www666www6661/WEILAI-DAFU-HW/production/dafu/gerbers/drill-report.txt

Drill report for DAFU.kicad_pcb
Created on 2026-10-12T19:56:31

Copper Layer Stackup:
    =============================================================
    L1 :  F.Cu                      front
    L2 :  B.Cu                      back

Drill file 'DAFU.drl' contains
    plated through holes:
    =============================================================
    T1  0.300mm  0.0118"  (74 holes))

    Total plated holes count 74

Not plated through holes are merged with plated holes
    unplated through holes:
    =============================================================

    Total unplated holes count 0
