www666www6661/WEILAI-DAFU-HW/production/dafu/documentation/LAYOUT-NOTES.md

# DAFU-DEMO-V0.2.1 生产文件说明

生成日期：2026-10-12。按用户最新保存的正式工程导出，包含此次 U6、U9 替换及后续手动修改。

PCB SHA-256：`16c16d32f7731cb15bf84564cf54f34b62e3aa2eb81f13218ef568a6f13b8d69`。

## 当前板数据

- 双层板，板厚 1.6 mm，板框 30.0 × 31.6 mm，四角各 1 mm 倒角，面积 946.0 mm²。
- 47 个封装：45 个正面、2 个底面；底面仅 TP5、TP6 裸测试焊盘。实际装配元件 42 个，均在正面。
- 322 段走线、74 个过孔，全部过孔孔径 0.30 mm；GND 过孔 50 个。
- 已保存的底层 GND 为单个实心直连铺铜区和单个填充多边形。
- 已保存的原生泪滴 279 个，正面 253 个、底面 26 个，全部有填充。
- 底层丝印板名 `DAFU-DEMO-V0.2.1`，文字 `CONF_CONC`，日期 `2026-10-12`。

本次直接按已保存的铜区、泪滴导出，未重新填铜、重新生成泪滴或修改正式工程。Gerber、钻孔和铜层预览来自正式 PCB 的精确快照；装配用临时副本仅用于显示标号和正确处理 C11 不装属性。

3D 预览也使用装配副本，以正确显示 C11 不装；正式生产铜层和钻孔使用原 PCB。

## 装配

- U6 为 TI `TLC2274AIDR`，U9 为 UMW `OPA333AIDBVR`。BOM 已带上工程中已有的 Manufacturer、MPN；缺失的采购料号保留空白。
- C11 在原理图标注 DNP，PCB 未同步这个属性。本次 BOM 按原理图明确标为不装，贴装坐标排除 C11，装配图对其打叉。其铜、阻焊和锡膏开窗保持源 PCB 原样。
- 正面贴装 CSV 仅含 42 个实际装配元件，底面贴装 CSV 无元件；TP1、TP2、TP5、TP6 为裸焊盘，不进入贴装文件。
- `DAFU-reference-positions.csv` 含全部 47 个标号的检查坐标，使用 PCB 中原始的正 Y 坐标，不能作为贴装文件。
- 正反面贴装 CSV 使用 KiCad 绝对原点、毫米单位、X 和取负后的 Y；角度沿用 KiCad。背面装配图和预览以从板背面观察的方向镜像，Gerber 不镜像。

## 检查及现有警告

- KiCad 10.0.5 ERC：0 项违规。
- PCB 检查包括全部走线错误、全部严重级别及原理图一致性：活动违规 0 项，未连接 0 项。
- 原有 5 项一致性警告保留：C11 DNP 属性不一致，以及 U2 缺少 10、17、18、19 号焊盘。原理图中这四脚均标注 No Connect。
- 实际 MCU 仍有 48 个引脚；上述四脚在源 PCB 和本生产图层中均没有铜焊盘、阻焊及锡膏开窗。
- 原有 1 项已排除的 U2 封装库不匹配警告保留，本次未新增排除规则。本版不能描述为 DRC 全零。
- 全部贴装坐标与源 PCB 核对，全部 74 个钻孔坐标与过孔核对；预览和装配图完成目视检查。

## 输出

- `gerbers/`：8 个生产图层、Gerber job、Excellon 钻孔及钻孔报告。底层无锡膏，不输出 B.Paste。
- `assembly/`：BOM、正反面贴装坐标、全标号检查坐标、正反面装配 SVG/PDF。
- `previews/`：最新正反面铜层、丝印 SVG/PNG 和 3D PNG。
- `documentation/`：本版 DRC、ERC、板数据、核查及本说明。
- `manifest.json`：源文件及输出文件 SHA-256；`../dafu.zip.sha256` 为完整压缩包校验值。
- `../dafu-gerbers.zip`：单独的打板压缩包，仅含 `gerbers/` 下的文件，便于上传板厂。

2026-10-16 按仓库格式整理至 `production/dafu/`，更新归档名称及校验清单；生产图层、钻孔、BOM、贴装坐标和装配图保持 2026-10-12 导出内容。

本次完成生产输出及文件核对，未实测冲击波形、噪声、量程或采样性能。
