www666www6661/WEILAI-DAFU-HW/production/dafu/previews/back-3d.png

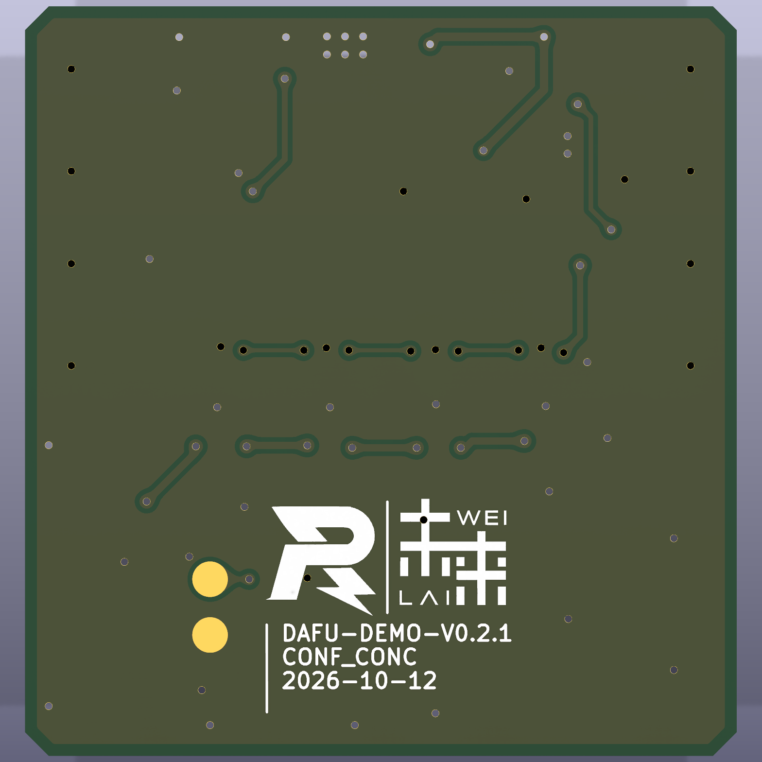
production/dafu/previews/back-3d.png
