www666www6661/WEILAI-DAFU-HW/production/dafu/previews/back-copper.png

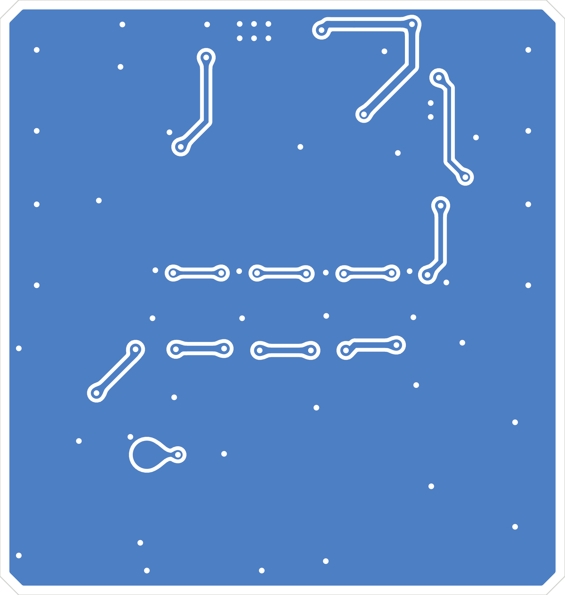
production/dafu/previews/back-copper.png
