www666www6661/WEILAI-DAFU-HW/production/dafu/previews/back-silkscreen.png

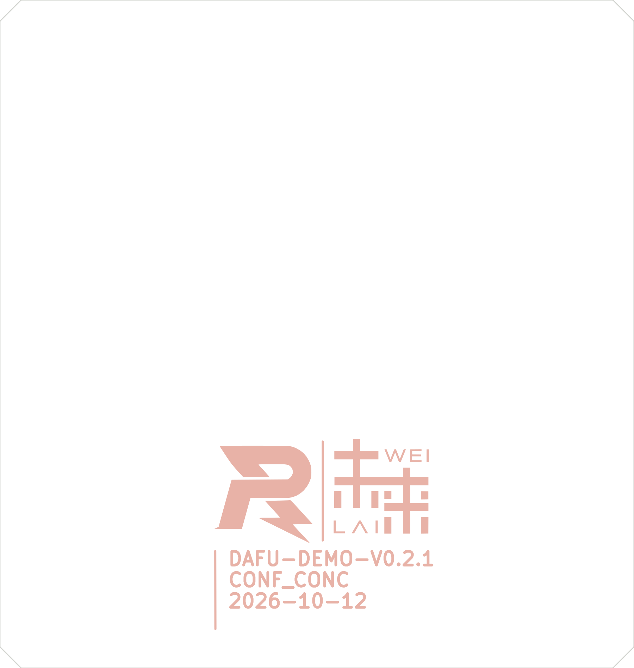
production/dafu/previews/back-silkscreen.png
