www666www6661/WEILAI-DAFU-HW/production/dafu/previews/front-3d.png

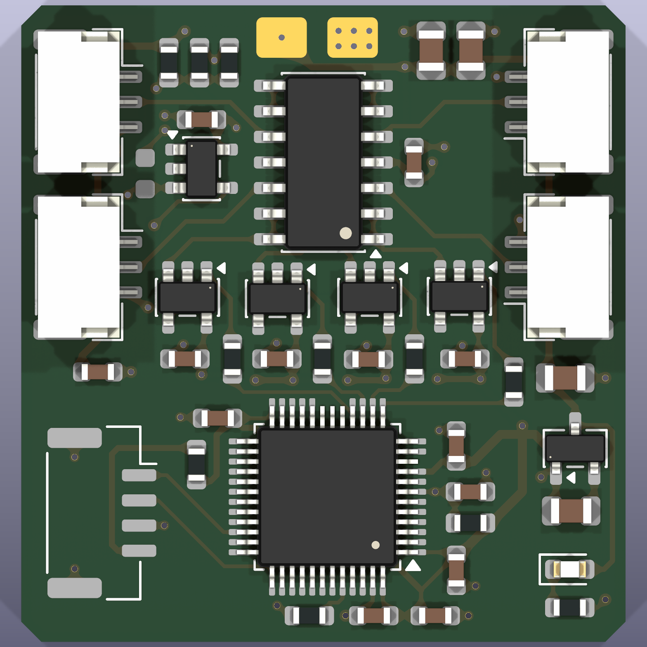
production/dafu/previews/front-3d.png
