www666www6661/WEILAI-DAFU-HW/production/dafu/previews/front-copper.png

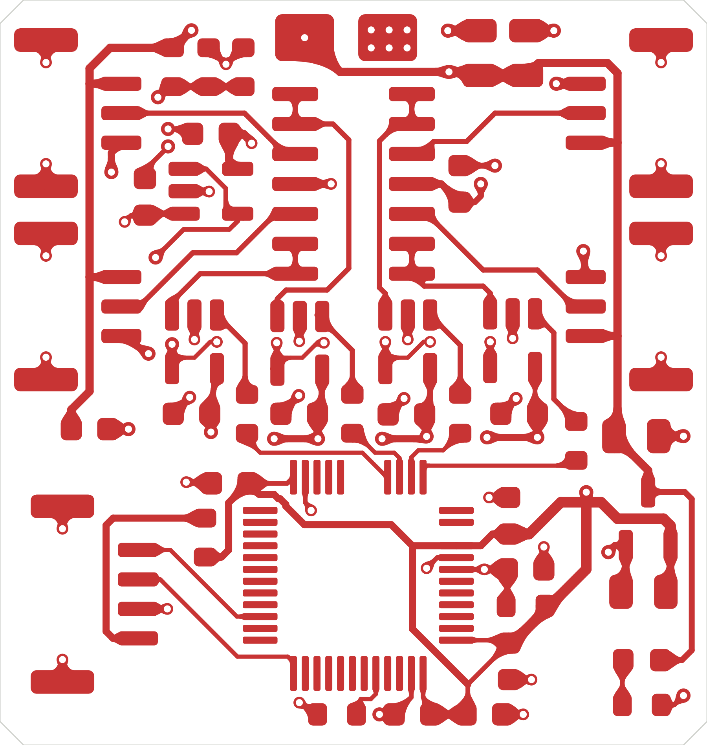
production/dafu/previews/front-copper.png
