www666www6661/WEILAI-DAFU-HW/production/dafu/previews/front-silkscreen.png

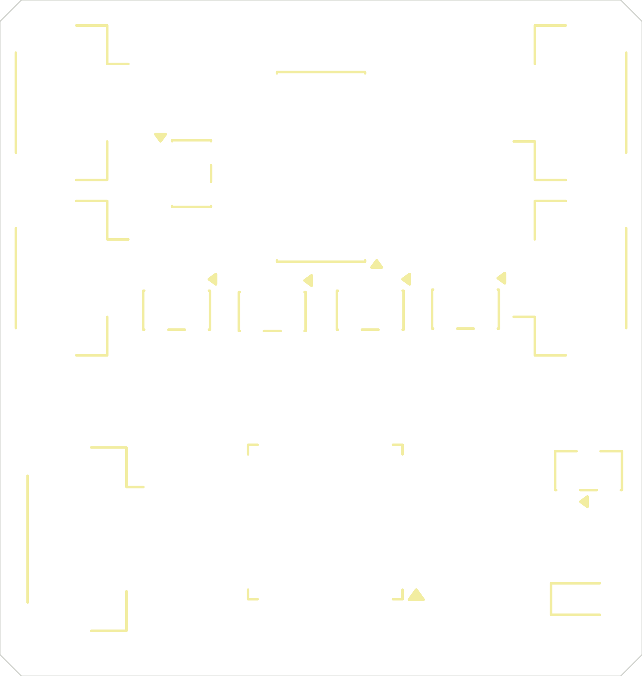
production/dafu/previews/front-silkscreen.png
