www666www6661/WEILAI-DAFU-HW/production/dafu/assembly/DAFU-back-assembly.pdf

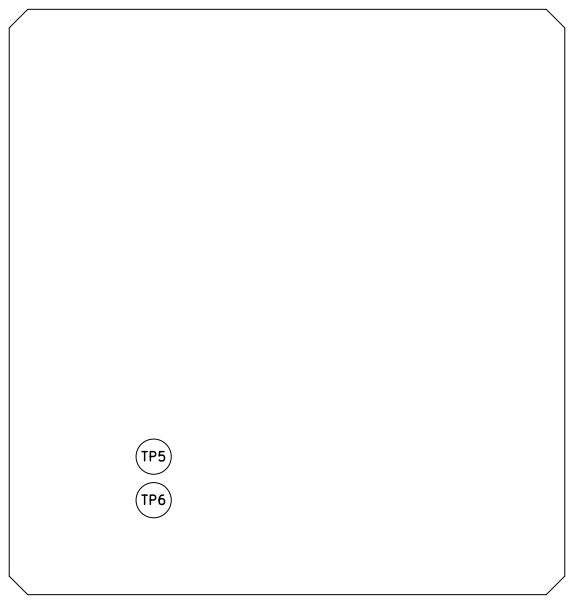
[picture p8: page 1]
