www666www6661/WEILAI-DAFU-HW/production/dafu/assembly/DAFU-front-assembly.pdf

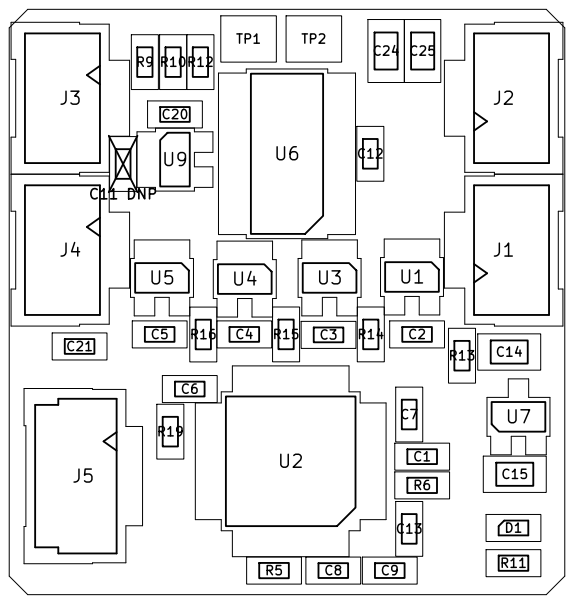
[picture p9: page 1]
