www666www6661/WEILAI-DAFU-HW/DAFU.kicad_pcb

## KiCad design DAFU.kicad_pcb (2026-10-16)

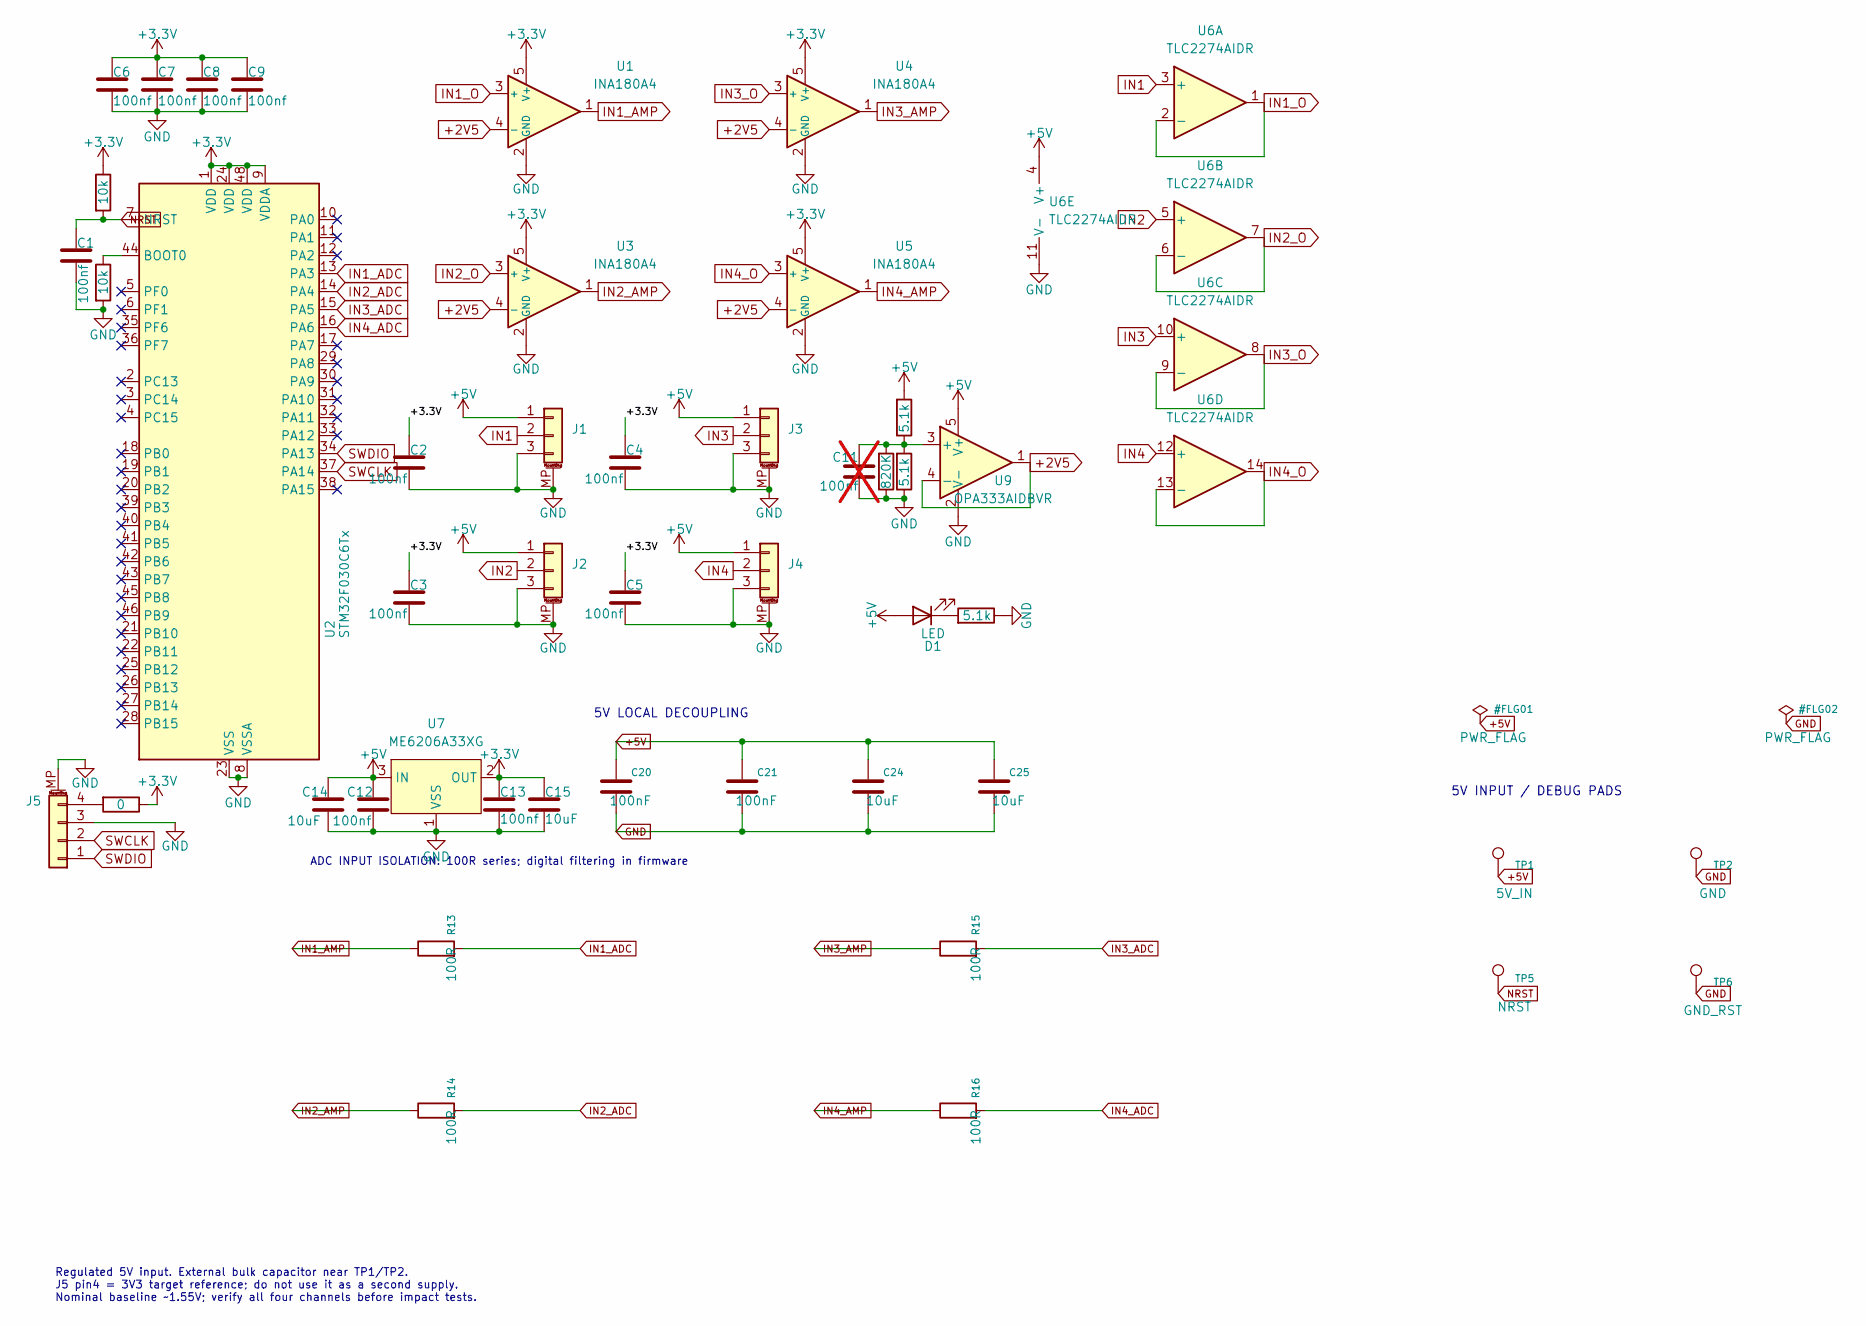
[picture p10: schematic DAFU.kicad_sch]

Parts:
C1, C2, C3, C4, C5, C6, C7, C8, C9, C12, C13: 100nf; C_0603_1608Metric
C11: 100nf; C_0603_1608Metric; not fitted
C14, C15, C24, C25: 10uF; C_0805_2012Metric; Voltage 16V
C20, C21: 100nF; C_0603_1608Metric
D1: LED; LED_0603_1608Metric
J1, J2, J3, J4: Conn_01x03_MountingPin; JST_GH_SM03B-GHS-TB_1x03-1MP_P1.25mm_Horizontal
J5: Conn_01x04; Molex_CLIK-Mate_502386-0470_1x04-1MP_P1.25mm_Horizontal
R5, R6: 10k; R_0603_1608Metric
R9, R10: 5.1k; R_0603_1608Metric; Tolerance 0.1%
R11: 5.1k; R_0603_1608Metric
R12: 820K; R_0603_1608Metric
R13, R14, R15, R16: 100R; R_0603_1608Metric
R19: 0; R_0603_1608Metric
TP1: 5V_IN; SolderWire_Pad_2.5x2.5mm
TP2: GND; SolderWire_Pad_2.5x2.5mm
TP5: NRST; TestPoint_Pad_D1.5mm
TP6: GND_RST; TestPoint_Pad_D1.5mm
U1, U3, U4, U5: INA180A4; SOT-23-5
U2: STM32F030C6Tx; LQFP-48_7x7mm_P0.5mm
U6: TLC2274AIDR; SOIC-14_3.9x8.7mm_P1.27mm; MPN TLC2274AIDR
U7: ME6206A33XG; SOT-23-3
U9: OPA333AIDBVR; SOT-23-5; MPN OPA333AIDBVR

Connections:
+2V5: U1.4 (-), U3.4 (-), U4.4 (-), U5.4 (-), U9.1, U9.4 (-)
+3.3V: C2.1, C3.1, C4.1, C5.1, C6.1, C7.1, C8.1, C9.1, C13.1, C15.1, R6.1, R19.1, U1.5 (V+), U2.1 (VDD), U2.9 (VDDA), U2.24 (VDD), U2.48 (VDD), U3.5 (V+), U4.5 (V+), U5.5 (V+), U7.2 (OUT)
+5V: C12.1, C14.1, C20.1, C21.1, C24.1, C25.1, D1.2 (A), J1.1, J2.1, J3.1, J4.1, R9.2, TP1.1, U6.4 (V+), U7.3 (IN), U9.5 (V+)
GND: C1.2, C2.2, C3.2, C4.2, C5.2, C6.2, C7.2, C8.2, C9.2, C11.2, C12.2, C13.2, C14.2, C15.2, C20.2, C21.2, C24.2, C25.2, J1.3, J1.MP (MountPin), J2.3, J2.MP (MountPin), J3.3, J3.MP (MountPin), J4.3, J4.MP (MountPin), J5.3, J5.MP (MountPin), R5.2, R10.1, R11.1, R12.1, TP2.1, TP6.1, U1.2 (GND), U2.8 (VSSA), U2.23 (VSS), U2.47 (VSS), U3.2 (GND), U4.2 (GND), U5.2 (GND), U6.11 (V-), U7.1 (VSS), U9.2 (V-)
IN1: J1.2, U6.3 (+)
IN1_ADC: R13.2, U2.13 (PA3)
IN1_AMP: R13.1, U1.1
IN1_O: U1.3 (+), U6.1, U6.2 (-)
IN2: J2.2, U6.5 (+)
IN2_ADC: R14.2, U2.14 (PA4)
IN2_AMP: R14.1, U3.1
IN2_O: U3.3 (+), U6.6 (-), U6.7
IN3: J3.2, U6.10 (+)
IN3_ADC: R15.2, U2.15 (PA5)
IN3_AMP: R15.1, U4.1
IN3_O: U4.3 (+), U6.8, U6.9 (-)
IN4: J4.2, U6.12 (+)
IN4_ADC: R16.2, U2.16 (PA6)
IN4_AMP: R16.1, U5.1
IN4_O: U5.3 (+), U6.13 (-), U6.14
NRST: C1.1, R6.2, TP5.1, U2.7 (NRST)
unnamed: D1.1 (K), R11.2
unnamed: J5.4, R19.2
unnamed: R5.1, U2.44 (BOOT0)
unnamed: C11.1, R9.1, R10.2, R12.2, U9.3 (+)
SWCLK: J5.2, U2.37 (PA14)
SWDIO: J5.1, U2.34 (PA13)

Notes on the sheet:
5V INPUT / DEBUG PADS
ADC INPUT ISOLATION: 100R series; digital filtering in firmware
5V LOCAL DECOUPLING
Regulated 5V input. External bulk capacitor near TP1/TP2. J5 pin4 = 3V3 target reference; do not use it as a second supply. Nominal baseline ~1.55V; verify all four channels before impact tests.

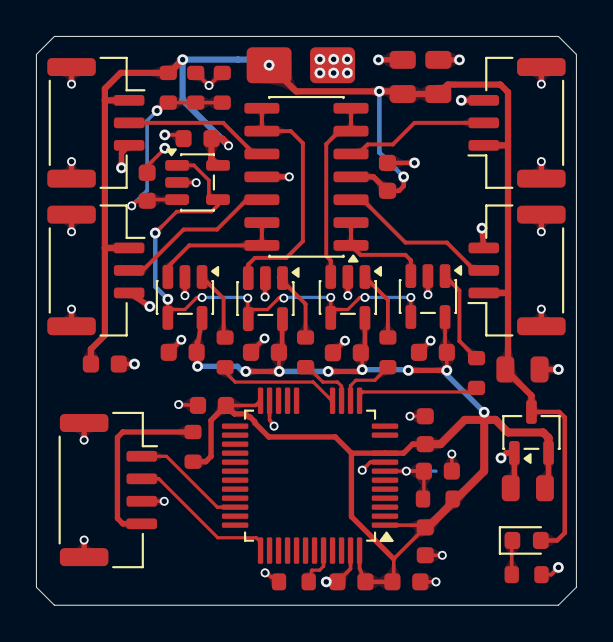
[picture p11: board DAFU.kicad_pcb from above]

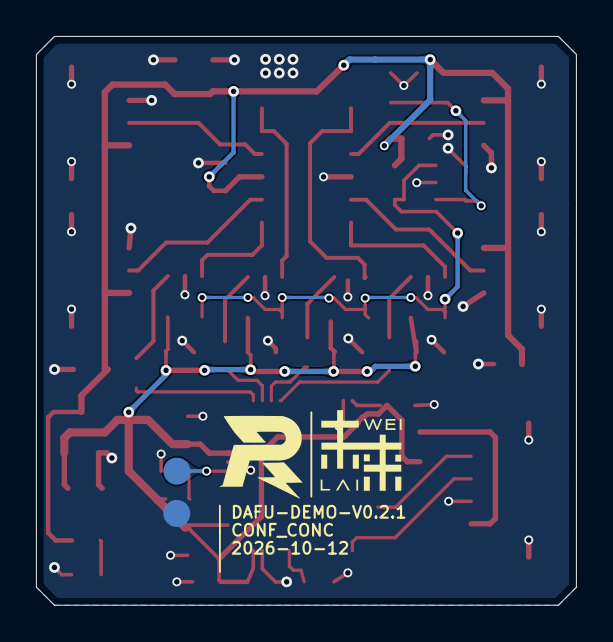
[picture p12: board DAFU.kicad_pcb from below]

Board: 2 copper layers, 30.0 x 31.6 mm, 47 parts (2 on the bottom side), 27 nets.
